fab-rodrigs/portable-oscilloscope-pi3/docs/etapa-3/relatorio-integracao.md

# Relatório de Integração

Este relatório descreve as etapas de integração entre o aplicativo, o firmware e o hardware do osciloscópio embarcado.

---

## 1. Integração Inicial

A primeira etapa consistiu em testar a comunicação usando dados sintéticos, enviados pelo microcontrolador apenas para validar o fluxo:

- Teste de conexão
- Teste de pacotes simples
- Teste de buffer circular

Isso permitiu validar que o app estava interpretando corretamente a estrutura dos pacotes.

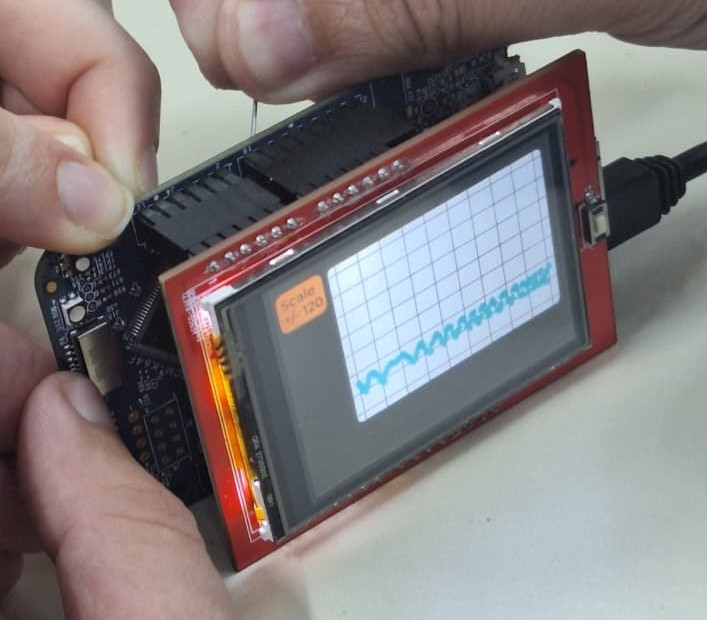
[picture p2: docs/etapa-3/imagens/integracao_display_mcc.jpg]
integração Display e microcontrolador


---

## 2. Integração com o Firmware Real

Após os testes iniciais, o firmware passou a enviar amostras reais capturadas pelo ADC do microcontrolador.

Testes executados:

- Taxa de amostragem vs. taxa de transmissão
- Estabilidade da comunicação
- Sincronização entre pacotes
- Verificação de perda de dados

Ajustes realizados:

- Padronização do tamanho do pacote
- Correção de latência no app
- Mecanismo de recuperação de pacotes perdidos

---

## 3. Integração com Hardware Completo

Nesta fase, o hardware já incluía:

- Conversão de sinal
- Alimentação
- Case prototipado (primeira versão)

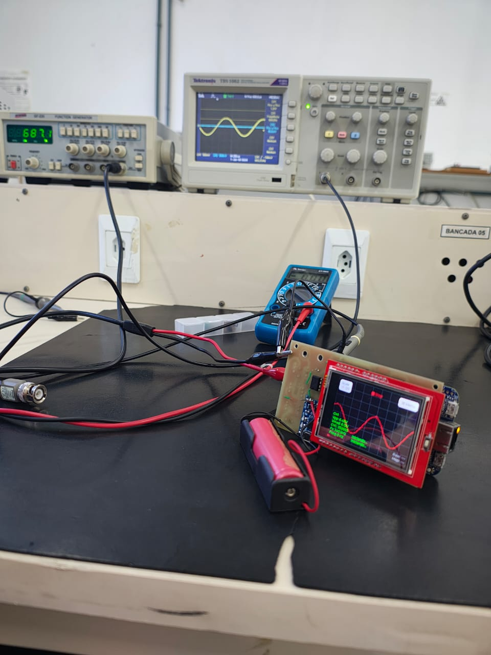
[picture p3: docs/etapa-3/imagens/integracao_pre_case.jpeg]
Integração pre-case
 

Validações feitas:

- Acesso aos conectores
- Estabilidade sob uso contínuo
- Testes de ruído e interferência elétrica
- Temperatura interna do case

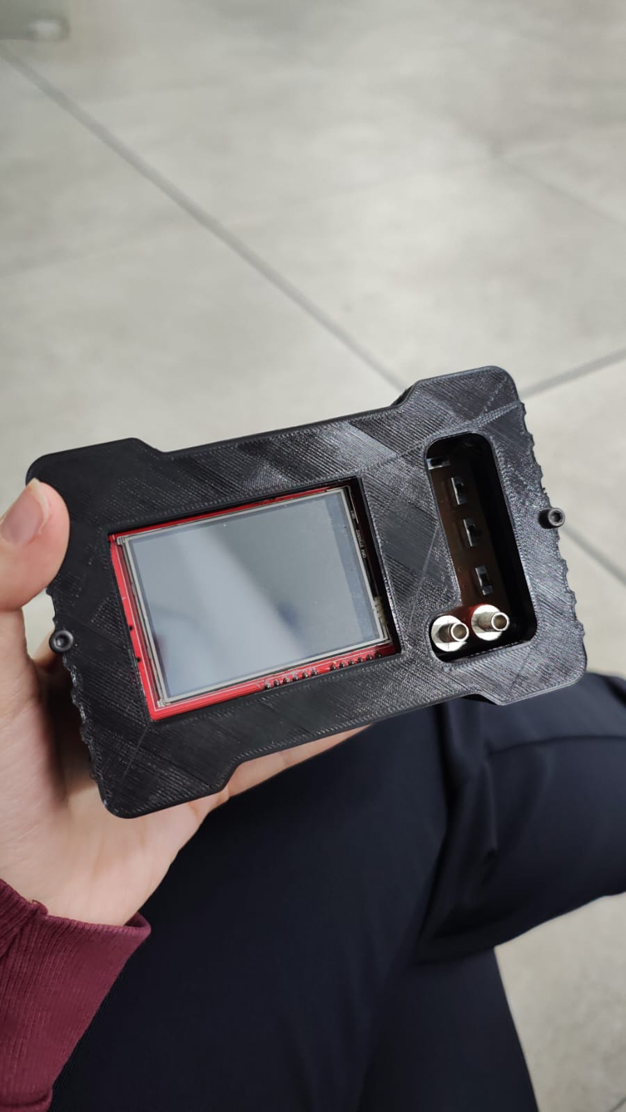
[picture p4: docs/etapa-3/imagens/integracao_3D.jpeg]
 

---

## 4. Conclusão

A integração demonstrou que o fluxo completo funciona:

**Sinal → Microcontrolador → App → Osciloscópio Visual**

A partir daqui, ajustes finos e aprimoramentos podem ser realizados conforme novos testes forem executados.

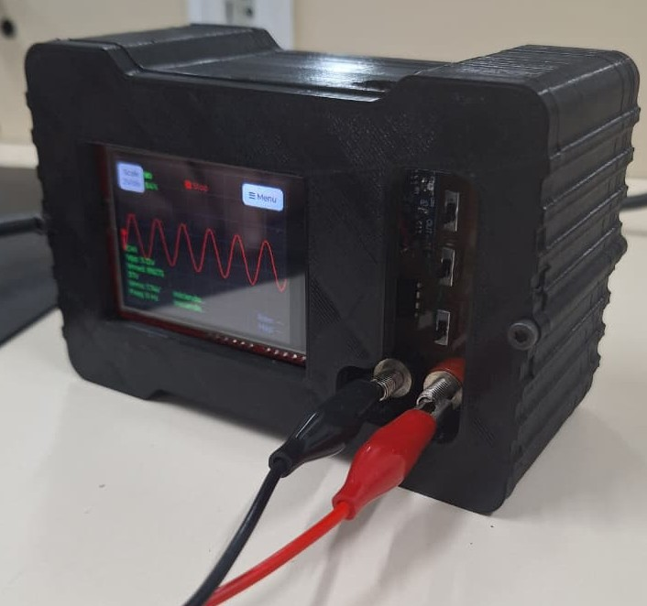
[picture p5: docs/etapa-3/imagens/integracao_final.jpeg]
