fab-rodrigs/portable-oscilloscope-pi3/docs/cronograma.md

# Cronograma do Projeto – Osciloscópio Portátil

## Etapa 1 – até 25/09
- Escolha do microcontrolador e módulo de comunicação.  
- Pesquisa protocolos de comunicação e medição de bateria.  
- Pesquisa touch screens.  
- Pesquisa sobre bateria e carregamento.  
- Definição de requisitos funcionais.  
- Criação de diagrama de blocos preliminar.  
- Revisão de literatura.  
- Divisão de tarefas entre membros.  
- Seleção de componentes e ferramentas.  

## Etapa 2 – até 16/10
- Testar periféricos do microcontrolador.  
- Testar touch screen (Arduino).  
- Testar circuito de carregamento de bateria.  
- Design inicial do case.  
- Produzir esquemático elétrico preliminar.  
- Layout PCB inicial.  
- Código dos testes de firmware.  
- Relatório de testes.  
- Manual de montagem preliminar.  

## Etapa 3 – até 13/11
- Desenvolver app de comunicação.  
- Integrar app, firmware e hardware.  
- Definir métodos de amostragem e filtros.  
- Revisar design do case.  
- Implementar monitoramento da bateria.  
- Fabricar protótipo do case.  
- Entregar código do app, relatório de integração e guia de instalação.  

## Etapa 4 – até 18/12
- Finalizar o case.  
- Testes end-to-end.  
- Correções e otimização.  
- Validação externa com usuários.  
- Produto final + lições aprendidas.  
- Relatório final, vídeo de demonstração e documentação completa.
