fab-rodrigs/portable-oscilloscope-pi3/docs/etapa-4/Apresentação final do produto.md

Captura de tela de 2025-12-18 18-16-59
