fab-rodrigs/portable-oscilloscope-pi3/docs/etapa-4/README.md

# Etapa 4

Este diretório corresponde à **Etapa 4 (última etapa)** do desenvolvimento do **Osciloscópio Portátil**, reunindo todos os materiais finais de entrega do projeto. Aqui estão consolidados os documentos técnicos, resultados de testes, apresentação do produto e o material de demonstração.

Esta etapa tem como objetivo **apresentar o produto final**, evidenciando seu funcionamento, validação por testes, documentação completa e demonstração prática.

---

## Conteúdo do Diretório

Neste diretório você encontrará os seguintes arquivos:

- **[Apresentação final do produto](./Apresentação%20final%20do%20produto.md)**  
  Documento voltado à apresentação do osciloscópio portátil, destacando o problema proposto, a solução desenvolvida, principais funcionalidades, arquitetura do sistema e diferenciais do projeto.

- **[Documentação completa do produto](./Documentação%20completa%20do%20produto.md)**  
  Documentação técnica detalhada do projeto, incluindo descrição do hardware, software, escolhas de projeto, requisitos funcionais e não funcionais, diagramas, gerenciamento de energia, limitações e considerações técnicas.

- **[Relatório final de testes](./Relatório%20final%20de%20testes.md)**  
  Relatório contendo os testes realizados no osciloscópio portátil, metodologia aplicada, critérios de validação, resultados obtidos, análise dos dados e conclusões sobre o desempenho do sistema.

- **[Vídeo de demonstração](./Video%20de%20demonstração.md)**  
  Documento com a descrição e/ou link para o vídeo de demonstração do funcionamento do osciloscópio portátil, evidenciando o uso prático do equipamento.

---

## Navegação Rápida

- Iniciar pela **[Apresentação final do produto](./Apresentação%20final%20do%20produto.md)**  
- Consultar os detalhes técnicos na **[Documentação completa do produto](./Documentação%20completa%20do%20produto.md)**  
- Verificar a validação no **[Relatório final de testes](./Relatório%20final%20de%20testes.md)**  
- Assistir à demonstração no **[Vídeo de demonstração](./Video%20de%20demonstração.mp4)**

---

## Considerações Finais

A Etapa 4 consolida todo o trabalho desenvolvido ao longo do projeto, apresentando o **produto final validado**, com documentação completa e demonstração funcional. Os materiais aqui disponibilizados permitem compreender tanto o **funcionamento prático** quanto as **decisões técnicas** envolvidas no desenvolvimento do osciloscópio portátil.

Este diretório representa a entrega final do projeto.
