fab-rodrigs/portable-oscilloscope-pi3/docs/etapa-3/imagens/integracao_placa2.jpeg

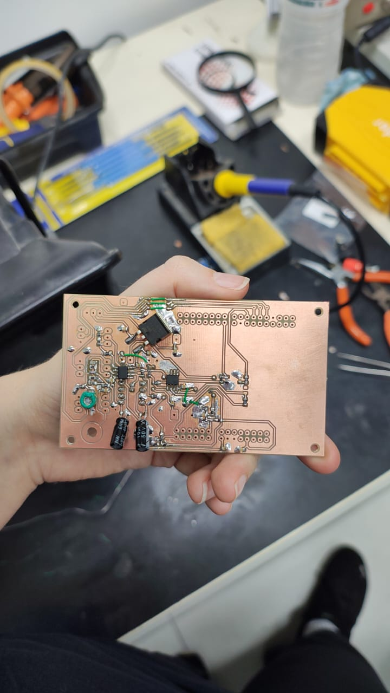
docs/etapa-3/imagens/integracao_placa2.jpeg
