fab-rodrigs/portable-oscilloscope-pi3/docs/etapa-3/imagens/integracao_placa.jpeg

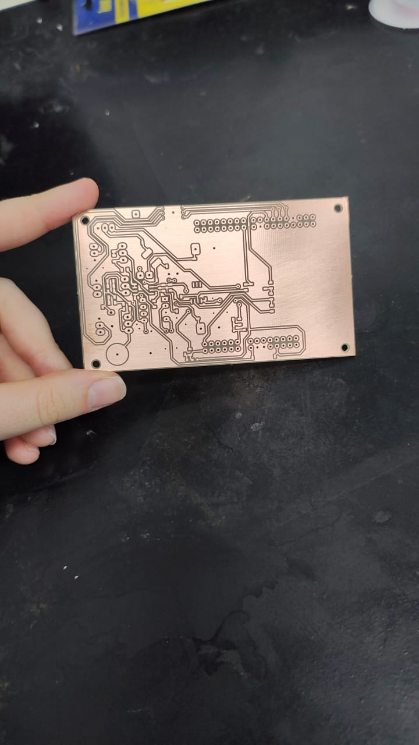
docs/etapa-3/imagens/integracao_placa.jpeg
