fab-rodrigs/portable-oscilloscope-pi3/docs/etapa-3/imagens/integracao_primeiro_3d.jpeg

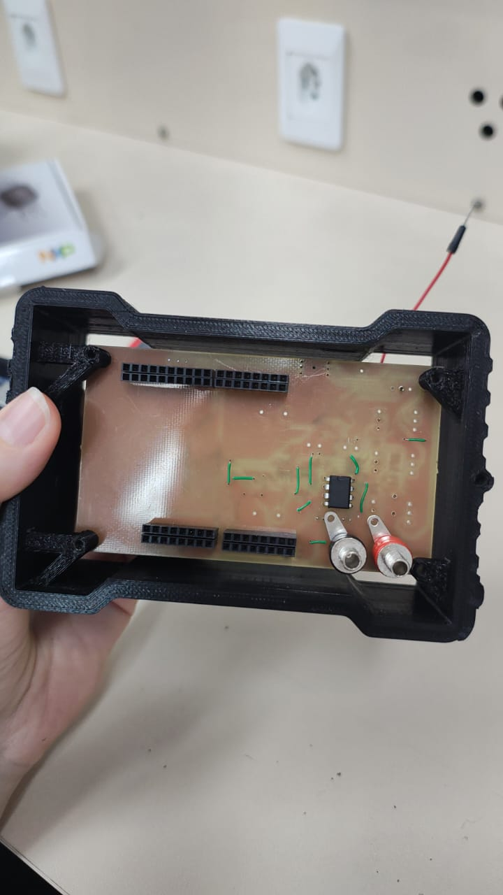
docs/etapa-3/imagens/integracao_primeiro_3d.jpeg
