fab-rodrigs/portable-oscilloscope-pi3/docs/etapa-3/imagens/integracao_sanduba.jpeg

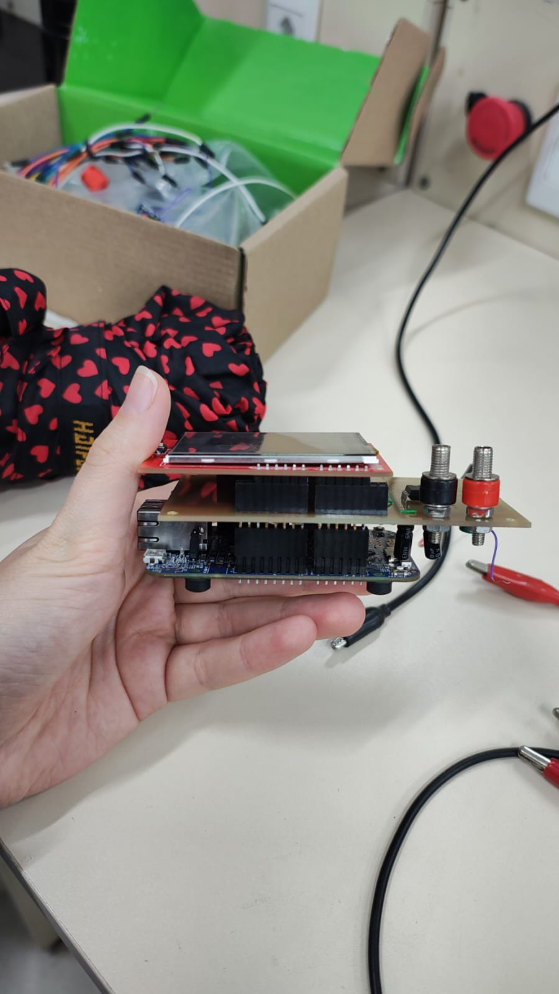
docs/etapa-3/imagens/integracao_sanduba.jpeg
