fab-rodrigs/portable-oscilloscope-pi3/docs/etapa-4/imagens/Captura de tela de 2025-12-18 18-16-59.png

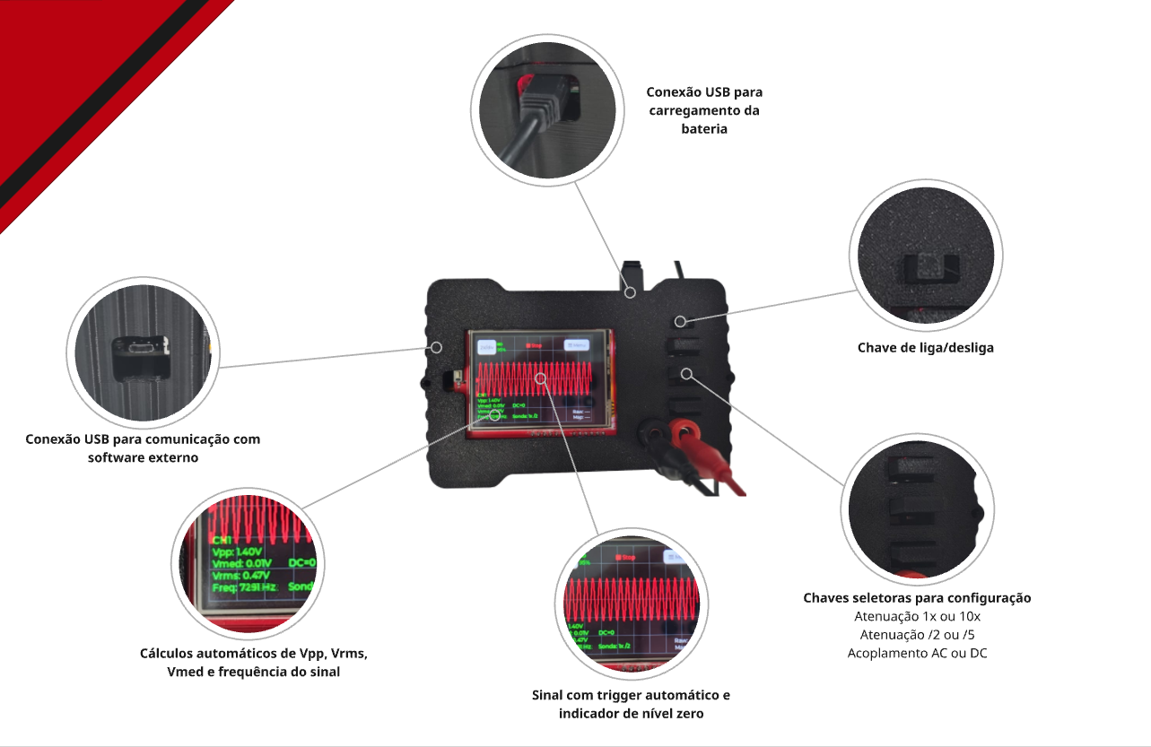
docs/etapa-4/imagens/Captura de tela de 2025-12-18 18-16-59.png
