fab-rodrigs/portable-oscilloscope-pi3/docs/etapa-4/imagens/case_final.jpeg

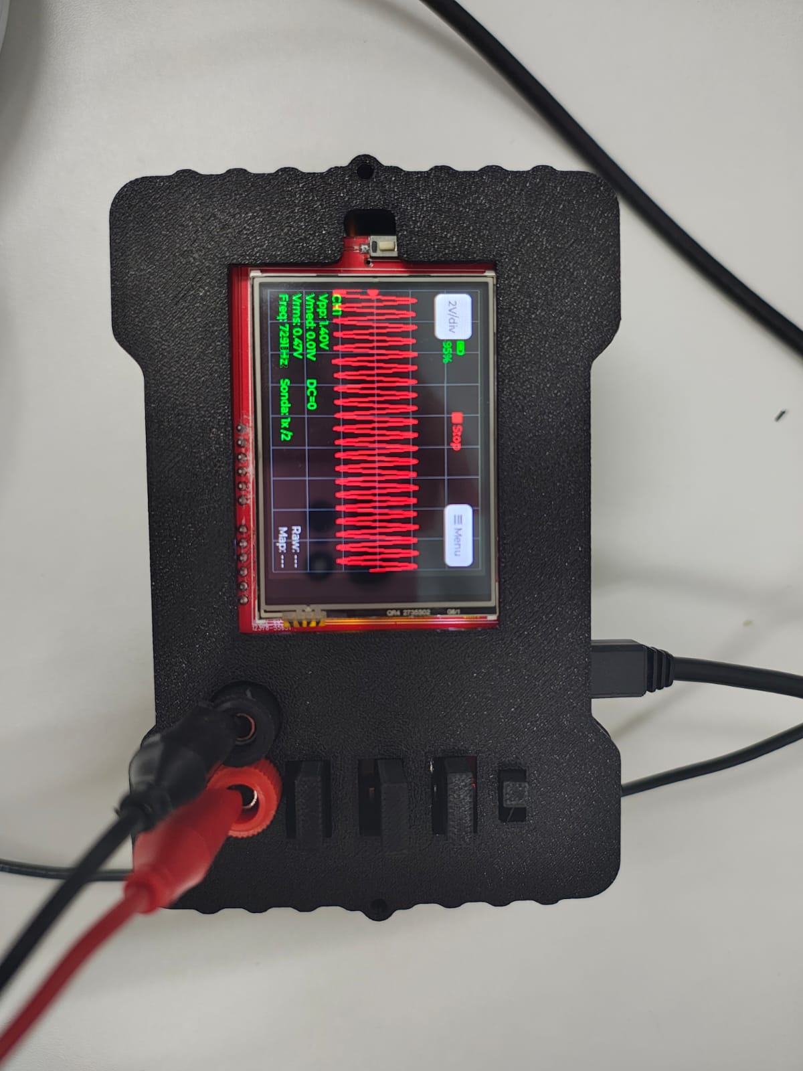
docs/etapa-4/imagens/case_final.jpeg
