fab-rodrigs/portable-oscilloscope-pi3/hardware/3d-models/18650-single-battery-enclosure-aliexpress-1.snapshot.2/18650 single battery enclosure.68.png

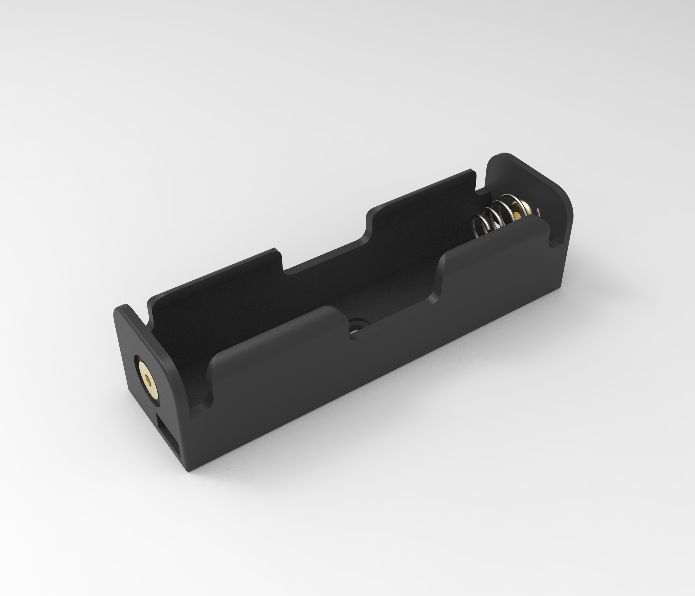
hardware/3d-models/18650-single-battery-enclosure-aliexpress-1.snapshot.2/18650 single battery enclosure.68.png
