fab-rodrigs/portable-oscilloscope-pi3/hardware/3d-models/freedom-k64f-frdm-k64f-1.snapshot.6/k64f.JPG

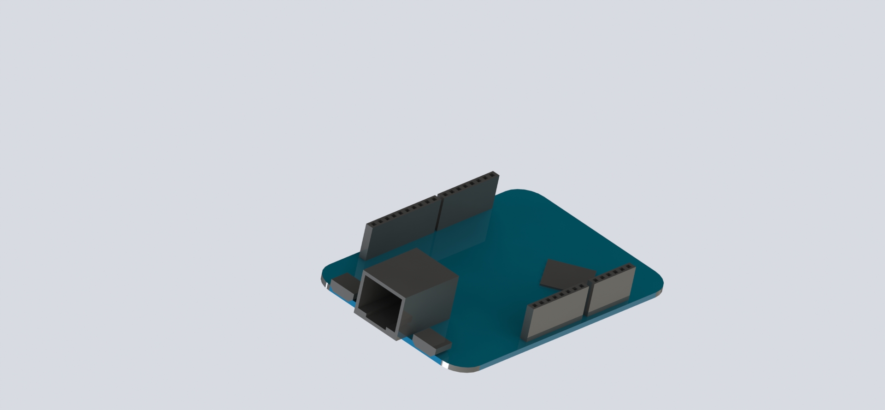
hardware/3d-models/freedom-k64f-frdm-k64f-1.snapshot.6/k64f.JPG
