fab-rodrigs/portable-oscilloscope-pi3/hardware/3d-models/lipo-charger-with-load-protection-tp4056-1.snapshot.4/4056 - With Batt Protection.PNG

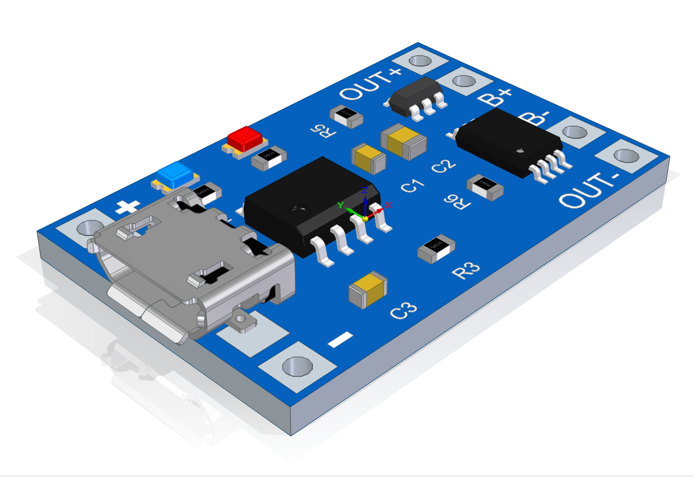
hardware/3d-models/lipo-charger-with-load-protection-tp4056-1.snapshot.4/4056 - With Batt Protection.PNG
