fab-rodrigs/portable-oscilloscope-pi3/hardware/3d-models/mar2406-1.snapshot.8/2.4TFT_module.png

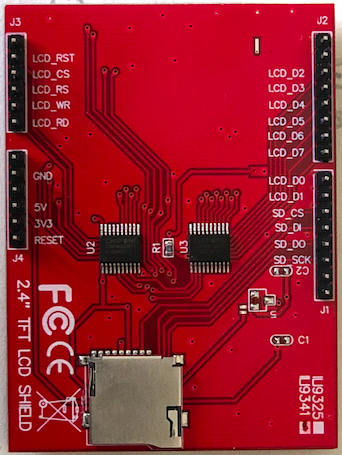
hardware/3d-models/mar2406-1.snapshot.8/2.4TFT_module.png
