fab-rodrigs/portable-oscilloscope-pi3/hardware/3d-models/mar2406-1.snapshot.8/MAR2406_view.png

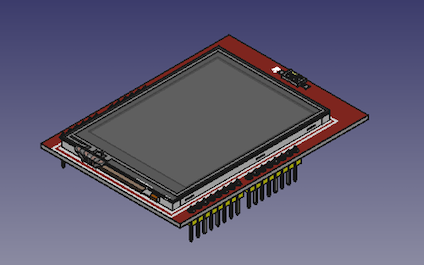
hardware/3d-models/mar2406-1.snapshot.8/MAR2406_view.png
