fab-rodrigs/portable-oscilloscope-pi3/hardware/3d-models/freedom-k64f-frdm-k64f-1.snapshot.6/K64F.STEP

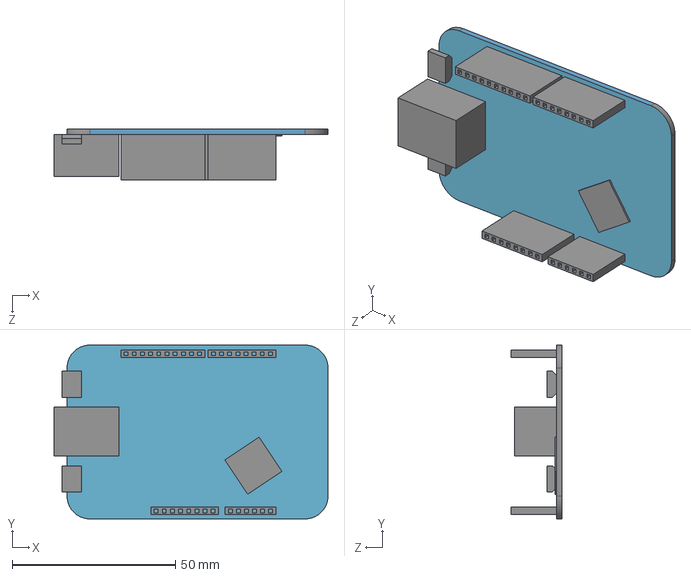
[picture p24: CAD file, 2025-10-16]
hardware/3d-models/freedom-k64f-frdm-k64f-1.snapshot.6/K64F.STEP
84.0 x 53.3 x 15.6 mm
