fab-rodrigs/portable-oscilloscope-pi3/hardware/3d-models/lipo-charger-with-load-protection-tp4056-1.snapshot.4/Lipo Charger - With Load Protection.stp

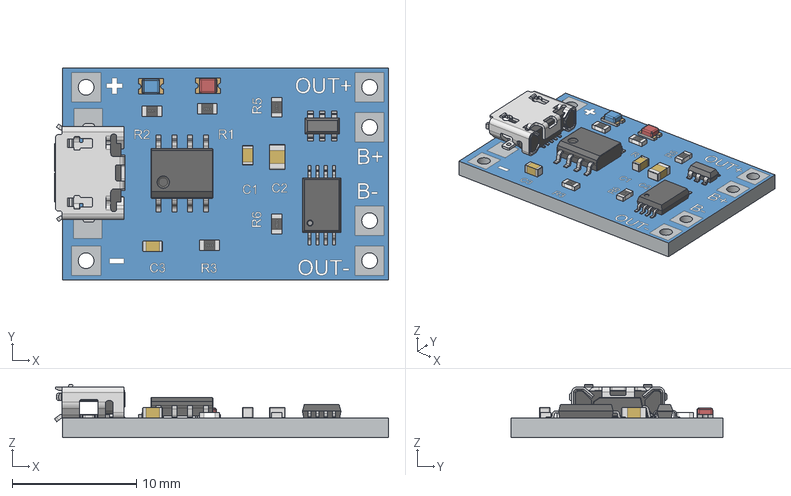
[picture p25: CAD file, 2025-10-16]
hardware/3d-models/lipo-charger-with-load-protection-tp4056-1.snapshot.4/Lipo Charger - With Load Protection.stp
26.9 x 17.1 x 4.28 mm
bOARD
0603 Capacitor x 2
0603 Resistor x 5
0805 Capacitor
SOIC-8-150
LED - 0805 - Blue
LED - 0805 - Red
USB - Micro
tsop8
sot-23-6-2
