fab-rodrigs/portable-oscilloscope-pi3/hardware/3d-models/18650-single-battery-enclosure-aliexpress-1.snapshot.2/18650 battery single enclosure.STEP

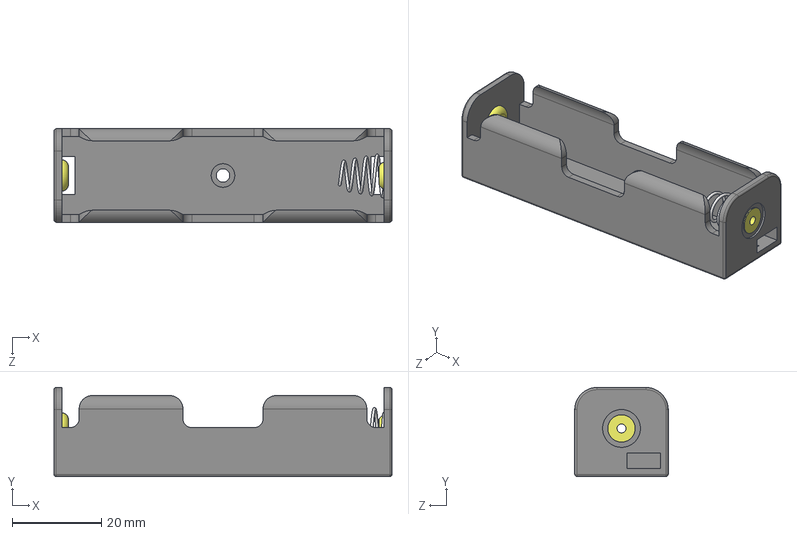
[picture p26: CAD file, 2025-10-16]
hardware/3d-models/18650-single-battery-enclosure-aliexpress-1.snapshot.2/18650 battery single enclosure.STEP
75.9 x 20.0 x 21.0 mm
