fab-rodrigs/portable-oscilloscope-pi3/(list of files, cad)

Other CAD files:
hardware/3d-models/18650-single-battery-enclosure-aliexpress-1.snapshot.2/18650 battery single enclosure.X_T
hardware/3d-models/freedom-k64f-frdm-k64f-1.snapshot.6/K64F.SLDPRT
