fab-rodrigs/portable-oscilloscope-pi3/docs/etapa-2/relatorio-testes-hardware.md

# Relatório de testes em Hardware

## Teste

Circuito de carregamento da bateria foi testado com o microcontrolador e a bateria, foi capaz de acender o Led do microcontrolador porém fraco.

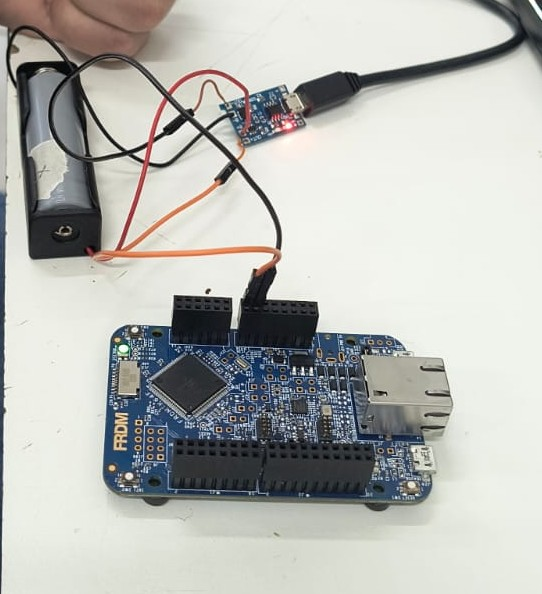
[picture p32: docs/etapa-2/Teste-bateria.jpg]
Teste do Circuito de bateria


O Display foi testado no microcontrolador, adapatando as bibliotecas e utilizando o software da NXP, MCUxpresso.
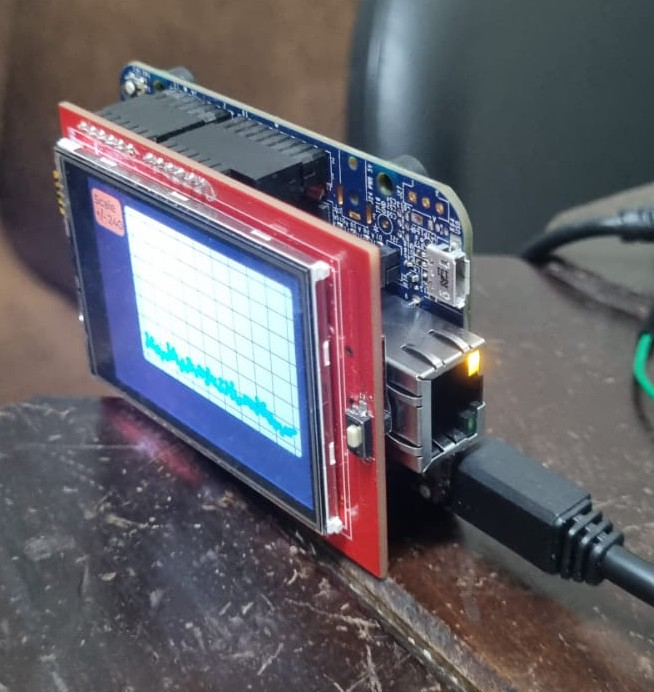
[picture p33: docs/etapa-2/Teste-display.jpg]
Teste do Display com o microcontrolador


O circuito de elevação e geração de tensão simétrica foi testado, permitindo uma alimentação adequada.
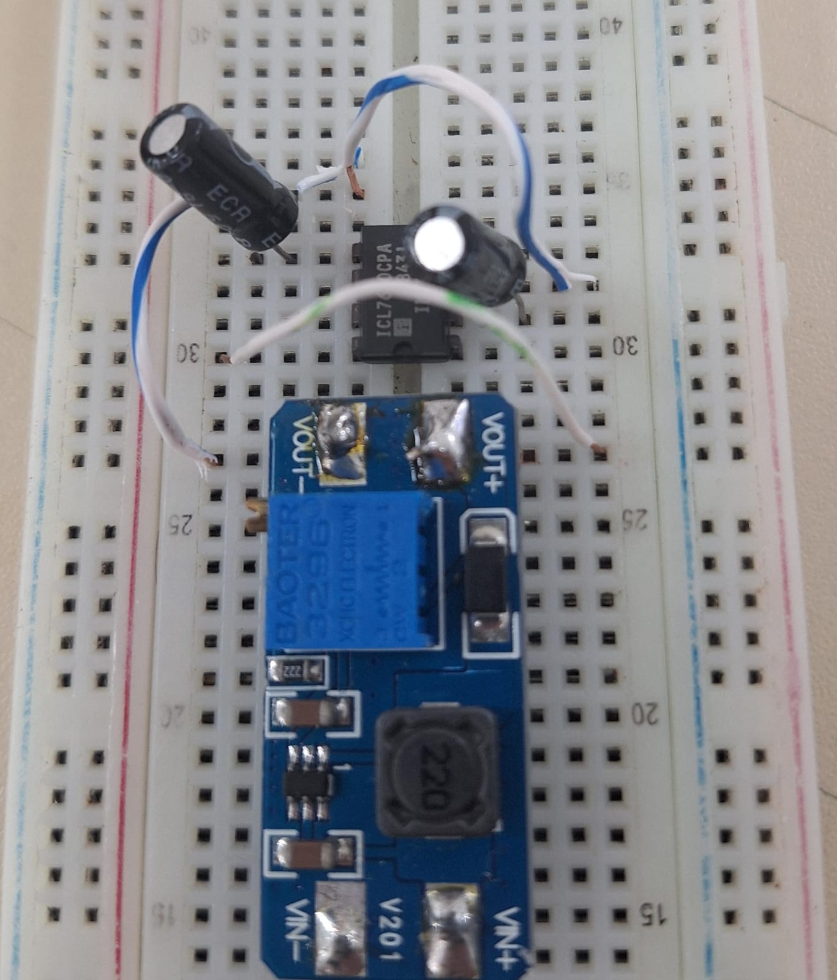
[picture p34: docs/etapa-2/teste-boost+pump.jpeg]
Teste do Boost+pump
