fab-rodrigs/portable-oscilloscope-pi3/docs/etapa-2/Teste-display-sem-fundo.png

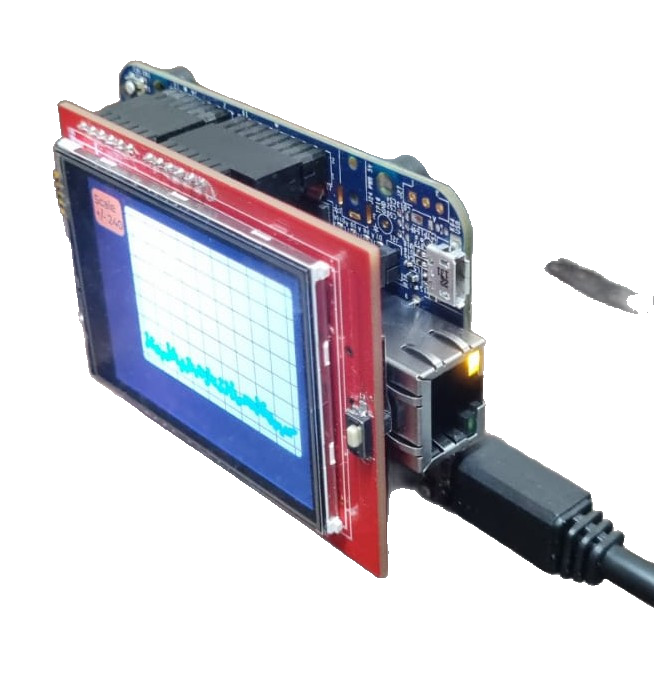
docs/etapa-2/Teste-display-sem-fundo.png
