fab-rodrigs/portable-oscilloscope-pi3/hardware/PI3/esquemático.pdf

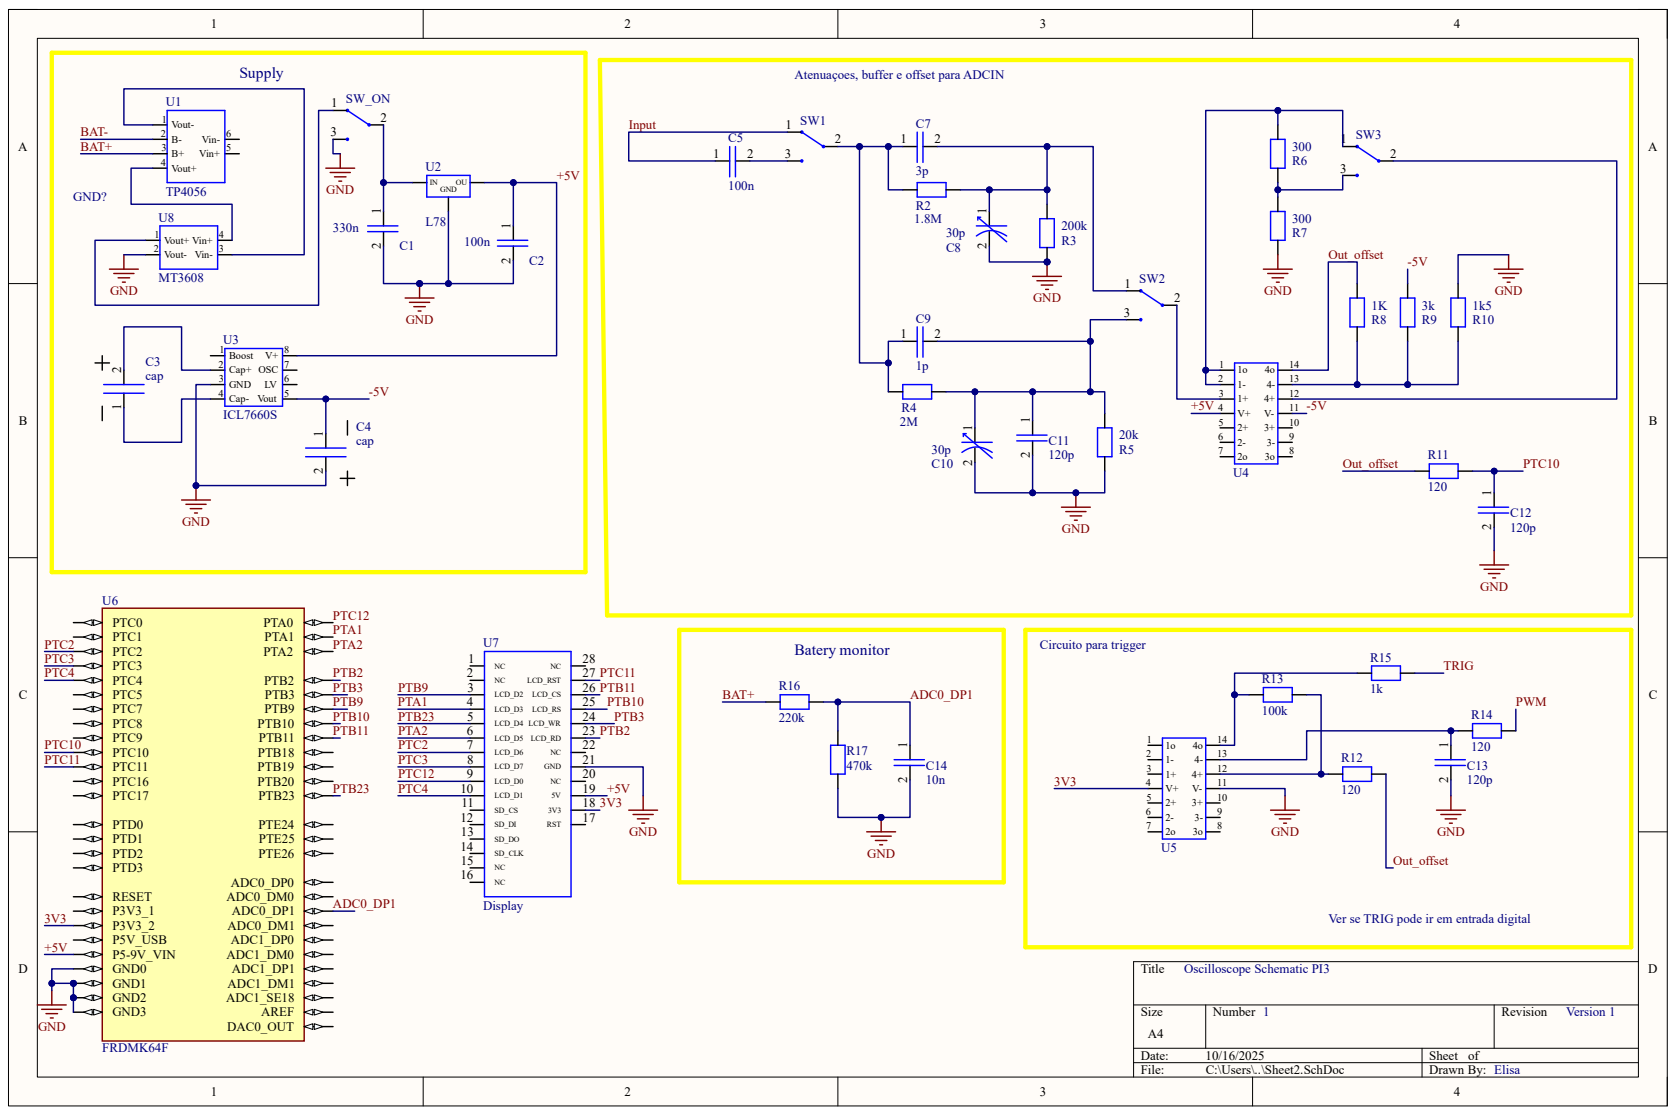
[picture p36: page 1]

Atenuaçoes, buffer e offset para ADCIN

Ver se TRIG pode ir em entrada digital
