fab-rodrigs/portable-oscilloscope-pi3/hardware/simulação/Draft3.asc

C1: cap; 7p
C2: cap; 30p
C3: cap; 100n
C4: cap; 10n
C5: cap; 100p
C6: cap; 100n
C7: cap; 220p
C8: cap; 100p
R1: res; 1000k
R2: res; 150
R3: res; 200k
R4: res; 1830k
R5: res; 100k
R6: res; 420
R7: res; 270
R8: res; 1k
R9: res; 3k3
R10: res; 1k5
R11: res; 150
R12: res; 150
R13: res; 100k
R14: res; 100k
R15: res; 1k
U1: TL084
U2: TL084
U3: TL084
V1: voltage; SINE(0 25 10k 0 0 0 10000)
V2: voltage; 5
V3: voltage; 5
V4: voltage; PULSE(0 3.3 0 0 0 2.5u 5u 10000)
Named nets: 0, V2, V1, VCC, VEE, X1, X2
.tran 0 0.05 0
multiplica sinal por 1 - Indicado para sinais pequenos até 1.6V
multiplica sinal por 100m
Sinal x 1/2
Sinal x 1/5
1,51V offset
max 10V -> V2 e X1
max 25V -> V2 e X2
Me procupa a pessoa selecionar errado e queimar a entrada do mcc
Pegar faz dois dividores de tensao, quando selecionar SW1 vai pra 3.3 ou 0 e entra num GPIO, o mesmo com o SW2. o divisor deve ter 3.3v
