fab-rodrigs/portable-oscilloscope-pi3/(list of files, drawings)

Other design files:
hardware/alimentação_osciloscópio/alimentação.pdsprj
hardware/PI3/PI3.PrjPcb
hardware/PI3/Sheet2.SchDoc
hardware/Pi3_SMD/Pi3_SMD.PrjPcb
hardware/Pi3_SMD/Sheet1.SchDoc
