fab-rodrigs/portable-oscilloscope-pi3/hardware/alimentação_osciloscópio/alimentação_osciloscópio.kicad_sch

## KiCad design hardware/alimentação_osciloscópio/alimentação_osciloscópio.kicad_sch (2025-09-18)

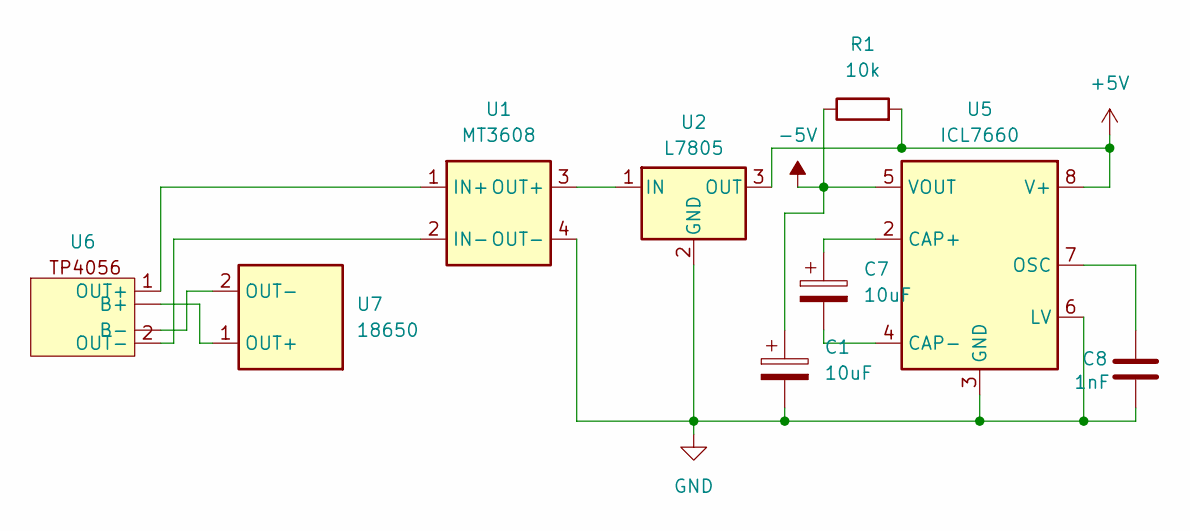
[picture p37: schematic alimentação_osciloscópio.kicad_sch]

Parts:
C1, C7: 10uF; CP_Radial_D5.0mm_P2.00mm
C8: 1nF; C_Disc_D10.5mm_W5.0mm_P5.00mm
R1: 10k; R_Axial_DIN0309_L9.0mm_D3.2mm_P15.24mm_Horizontal
U1: MT3608
U2: L7805; TO-220-3_Vertical
U5: ICL7660; DIP-8_W7.62mm_LongPads
U6: TP4056
U7: 18650; SOT-23-6

Connections:
+5V: R1.2, U2.3 (OUT), U5.8 (V+)
-5V: C1.1, R1.1, U5.5 (VOUT)
GND: C1.2, C8.2, U1.4 (OUT-), U2.2 (GND), U5.3 (GND), U5.6 (LV)
unnamed: C7.1, U5.2 (CAP+)
unnamed: C7.2, U5.4 (CAP-)
unnamed: C8.1, U5.7 (OSC)
unnamed: U1.1 (IN+), U6.1 (OUT+)
unnamed: U1.2 (IN-), U6.2 (OUT-)
unnamed: U1.3 (OUT+), U2.1 (IN)
unnamed: U6. (B+), U7.1 (OUT+), U7.2 (OUT-)
