fab-rodrigs/portable-oscilloscope-pi3/(commit log)

2025-09-18 Uploading files
    [alimentação.pdsprj, alimentação_osciloscópio.kicad_sch]
2025-09-25 Add files via upload
    Primeiro Diagrama de blocos
2025-10-15 3d models
    [18650 battery single enclosure.STEP, 18650 battery single enclosure.X_T, K64F.SLDPRT, K64F.STEP, Lipo Charger - With Load Protection.stp]
2025-10-16 Add display and mcc connections
    [PI3.PrjPcb, Sheet2.SchDoc]
2025-10-16 Update Schematic
    [Sheet2.SchDoc]
2025-10-16 Added ON OFF
    [Sheet2.SchDoc]
2025-10-16 Update esquematico-pcb.md
    Added all
2025-10-16 images PCB
2025-10-16 Update esquematico-pcb.md
    added PCB Layout pics
2025-10-16 more images
    [Sheet2.SchDoc]
2025-10-16 Add technical report for digital oscilloscope firmware
    Documenta a arquitetura e implementação do firmware para um osciloscópio digital na FRDM-K64F, incluindo detalhes sobre hardware, software, e desafios de performance.
2025-10-16 Revise o relatório técnico do firmware para versão 3.0
    Atualiza o relatório técnico do firmware para versão 3.0, detalhando otimizações e melhorias na manipulação de resoluções do ADC.
2025-10-16 Atualiza relatório técnico do firmware para versão 4.0
    Atualiza o relatório técnico do firmware para a versão 4.0, incluindo melhorias na arquitetura, desempenho e planos futuros.
2025-10-20 simulation docs
    [Sheet2.SchDoc]
2025-11-09 new layout smd
    [Pi3_SMD.PrjPcb, Sheet1.SchDoc, Sheet2.SchDoc]
2025-11-13 add layout
    [PCB2.DRL, PCB2.GBL, PCB2.GBO, PCB2.GBP, PCB2.GBS, PCB2.GKO, PCB2.GM1, PCB2.GTL]
2025-12-16 Create Video de demonstração
2025-12-17 Revise product documentation for clarity and detail
    Updated the product documentation to include details about battery management, safety features, and improved clarity in various sections.
2025-12-17 Rename Relatório final de testes to Relatório final de testes.md
2025-12-17 source code microcontroller update bugs
    [main.c]
2025-12-18 Add README for Stage 4 of Portable Oscilloscope project
    This directory corresponds to Stage 4 (final stage) of the Portable Oscilloscope project development, consolidating all final delivery materials. It includes technical documents, test results, product presentation, and demonstration material.
2025-12-18 Update Relatório final de testes.md
    wrote relatorio de testes
2025-12-18 Update Relatório final de testes.md
    edicoes
2025-12-18 Update Relatório final de testes.md
2025-12-18 Update Relatório final de testes.md
    add image
2025-12-18 Rename WhatsApp Video 2025-12-18 at 17.07.58.mp4 to Vídeo de demonstração
2025-12-18 Update Relatório final de testes.md
    aaaaaaa
2025-12-18 Rename Vídeo de demonstração to Vídeo de demonstração.mp4
2025-12-18 Rename Vídeo de demonstração.mp4 to Video de demonstração.mp4
2025-12-18 Update Relatório final de testes.md
    imagem testes
2025-12-18 Update Relatório final de testes.md
    imagens
